Ayexor/SoundLoc/README.md

# SoundLoc

Projekt SoundLoc von

Roy Seitz 			rseitz@hsr.ch
Marco Zollinger

HSR - Hochschule für Technik Rapperswil
Oberseestrasse 10
CH-8640 Rapperswil

Modul Digital Microelectronics DigME

Git-Repo created: 2016-11-14
