Ayexor/SoundLoc/Datasheet/project_datasheet/datasheet.tex

\input{header.tex}
\usepackage{subcaption}

\begin{document}
\maketitle
\setcounter{tocdepth}{2}

\begin{figure}[htbp]
	\begin{subfigure}{0.5\textwidth}
		\centering
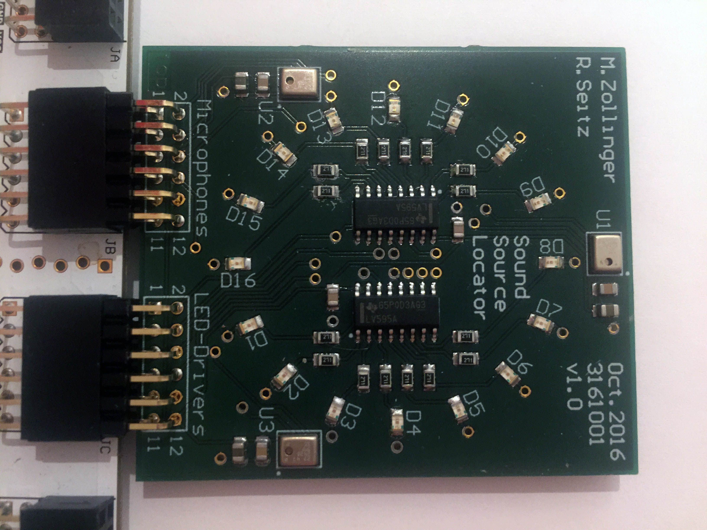
[picture p1: Datasheet/project_datasheet/block_diagram/pcb.jpg]
		
%		\captionof{figure}{SoundLoc PCB attached to FPGA board}
		\label{fig::pcb_view}
	\end{subfigure}
	\begin{subfigure}{0.5\textwidth}
		\centering
		
%		\captionof{figure}{Top Level Block Diagram}
		\label{fig::top_block}
	\end{subfigure}
	\caption{The PCB and a top level block diagram}
	\label{fig::system}
\end{figure}

\input{overview.tex}
\input{filter.tex}
\input{xcorr.tex}
\input{software.tex}
\input{display.tex}

\end{document}
