Ayexor/SoundLoc/Datasheet/project_datasheet/display.tex

\section{LED Display}
\label{sec::display}

The 16 LEDs are controlled by two 8-bit shift registers.
The LED nearest to the calculated direction is switched on every cycle.
Due to remaining noise and fast processing speed, interpolation seemingly happens by illuminating neighboring LEDs alternatively.
