Ayexor/SoundLoc/Datasheet/XCorr/block_diagram/xcorr_diag.tex

\input{picture_header}

%coordinates
\newcommand{\xt}	{0}
\newcommand{\xtc}	{0.75}
\newcommand{\xfa}	{1.5}
\newcommand{\xfac}	{2.25}
\newcommand{\xfb}	{3.0}
\newcommand{\xsat}	{4.5}
\newcommand{\xsa}	{6.0}

\newcommand{\yt}{3.0}
\newcommand{\ym}{1.5}
\newcommand{\yb}{0.0}

\begin{document}

	\tikzstyle{block} = [draw, fill=\blueFill, rectangle, minimum height=1cm, minimum width=1cm]
%	\tikzstyle{sum} = [draw, fill=\blueFill, circle, node distance=1cm]
%	\tikzstyle{input} = [coordinate]
%	\tikzstyle{output} = [coordinate]
%	\tikzstyle{pinstyle} = [pin edge={to-,thin,black}]

	\begin{tikzpicture}
%	\draw[style=my help lines] (0,0) grid (2,2);

	%top
	\draw (\xt, \yt) node[block](tau){Tau};
	\draw (\xfa, \yt) node[block](fat){$z^{-1}$};
	\draw (\xfb, \yt) node[block](fbt){$z^{-1}$};
	\draw (\xsat, \yt) node[block](sat){$z^{-1}$};
	%mid
	\draw (\xfa, \ym) node[block](FA){FA};
	\draw (\xfb, \ym) node[block](FB){FB};
	\draw (\xsa, \ym) node[block](SA){SA};
	%bottom
	\draw (\xfb, \yb) node[block](DSPA){DSP};
	\draw (\xsat, \yb) node[block](DSPB){DSP};
	
	%arrows
	\draw[->] (tau) -- (\xtc, \yt) |- (FA);
	\draw[->] (FA) |- (DSPA);
	\draw[->] (DSPA) -- (DSPB);
	\draw[->] (DSPB) -| (SA);
	
	\draw[->] (tau) -- (fat);
	\draw[->] (fat) -- (fbt);
	\draw[->] (fbt) -- (sat);
	\draw[->] (sat) -| (SA);
	
	\draw[->] (fat) -- (\xfac, \yt) |- (FB);
	\draw[->] (FB) -| (DSPB);
	
	\end{tikzpicture}
	
\end{document}
