Ayexor/SoundLoc/Datasheet/project_datasheet/software.tex

\section{Software}
\label{sec::software}

One ARM Cortex-A9 core is used in this project.
At first it configures the filter and cross-correlation blocks by setting order, decimation, IIR pole location and post division factor.
The filter delivers its values directly to the cross-correlation block, which again informs the Cortex-A9 each time recalculation is finished.
The Cortex-A9 then reads the result and searches for the maximum in the correlation which corresponds to the delay Tau of the microphone signal to the reference microphone. Tau is proportional to the signal delay caused by finite speed of sound.

If the distance between the microphones and the sound source is large compared to the distance between the microphones, the sound wave can be modeled as a plane wave.
The delays are then proportional to the inner product between the wave vector and the  distance between the correlated microphone, as expressed in (\ref{eq::inner_product}).

Since the microphones are arranged in a equilateral triangle, the two Taus are not orthogonal.
The vector $x$ directing to the source location in cartesian coordinates can be expressed as per the left side of (\ref{eq::base_transform}).
To calculate the signal delay in cartesian coordinates, $Bx$ needs to be left multiplied with $B^{-1}$, resulting in the right side of  (\ref{eq::base_transform}).

\begin{align}
	{Tau}_{0n} \propto \overrightarrow{k} \cdot &\overrightarrow{M_nM_0} \quad n\in\{1,2\}\label{eq::inner_product} \\
	\tau = Bx \quad &\Rightarrow \quad x = B^{-1}\tau \label{eq::base_transform}\\
	\begin{pmatrix} {Tau}_{01} \\ {Tau}_{02}\end{pmatrix}
		=  \begin{pmatrix} \cos(\frac{\pi}{3}) & \sin(\frac{\pi}{3}) \\ 1 & 0 \end{pmatrix} \begin{pmatrix} x \\ y\end{pmatrix}
	\quad &\Rightarrow \quad \begin{pmatrix} x \\ y \end{pmatrix}	
	= \begin{pmatrix} 0 & 1 \\ \frac{2}{\sqrt{3}} & -\frac{1}{\sqrt{3}}\end{pmatrix}
	\begin{pmatrix} {Tau}_{01} \\ {Tau}_{02}\end{pmatrix}
\end{align}

From the cartesian coordinates $x,y$, the four quadrant arctangent can easily be calculated using the C-function \emph{atan2(y,x)}.
The resulting angle is finally mapped to the corresponding LED and displayed.
