Ayexor/SoundLoc/Datasheet/project_datasheet/header.tex

\documentclass[a4papper, 11pt]{article}

\title{-- Digital Microelectronics --- SoundLoc -- \\ Localization of sound sources by cross-correlating \\ three $\Sigma\Delta$-microphone signals}
\author{Stefan Kull, Roy Seitz, Marco Zollinger}

\usepackage[T1]{fontenc}			%umlaute als eigene Zeichen
\usepackage[latin1]{inputenc}	%umlaute erkennen
\usepackage{lmodern}
\usepackage{amsmath} 					%mathematischen Textsatz.
\usepackage{amssymb}					%	-Erweiterte math. Sonderzeichen
\usepackage{dsfont}						%	-Mengen			
\usepackage[english]{babel}
\usepackage{textgreek}
\usepackage{siunitx}
\usepackage{graphicx}
\usepackage{caption}			%für \captionof

\usepackage[
	pdftitle={SoundLoc -- Digital Microelectronics Project},						%Titel des PDF Dokuments.
	pdfauthor={Stefan Kull, Roy Seitz, Marco Zollinger},									%Autor des PDF Dokuments.
	pdfsubject={Sound localization using cross-correlation of three microphones},		%Thema des PDF Dokuments.
	pdfcreator={LaTeX with hyperref and KOMA-Script},		%Erzeuger des PDF Dokuments.
	pdfkeywords={Cross-correlating, CIC, IP, AXI4\_Lite interface},						%auch für PDF Dokumente indexiert
	%	pdfpagemode=UseOutlines,								%Inhaltsverzeichnis anzeigen beim ffnen
	pdfdisplaydoctitle=true,								%Dokumenttitel statt Dateiname anzeigen.
	pdflang=en,												%Sprache des Dokuments.
	plainpages=false,
	hidelinks,												%keine Box um Links
	%	bookmarksopen.											%toc beim Öffnen expandiert
	pdfpagelabels
]{hyperref}

\usepackage[
%includeheadfoot,		%Kopf- und Fusszeilen verwenden
%headheight=15pt,		%Höhe der Kopfzeile
left=30mm,				%abstand von Seitenraendern
right=30mm,				%
top=20mm,
bottom=20mm,
%			twoside
]{geometry}
