Ayexor/SoundLoc/Hardware/layout.pdf

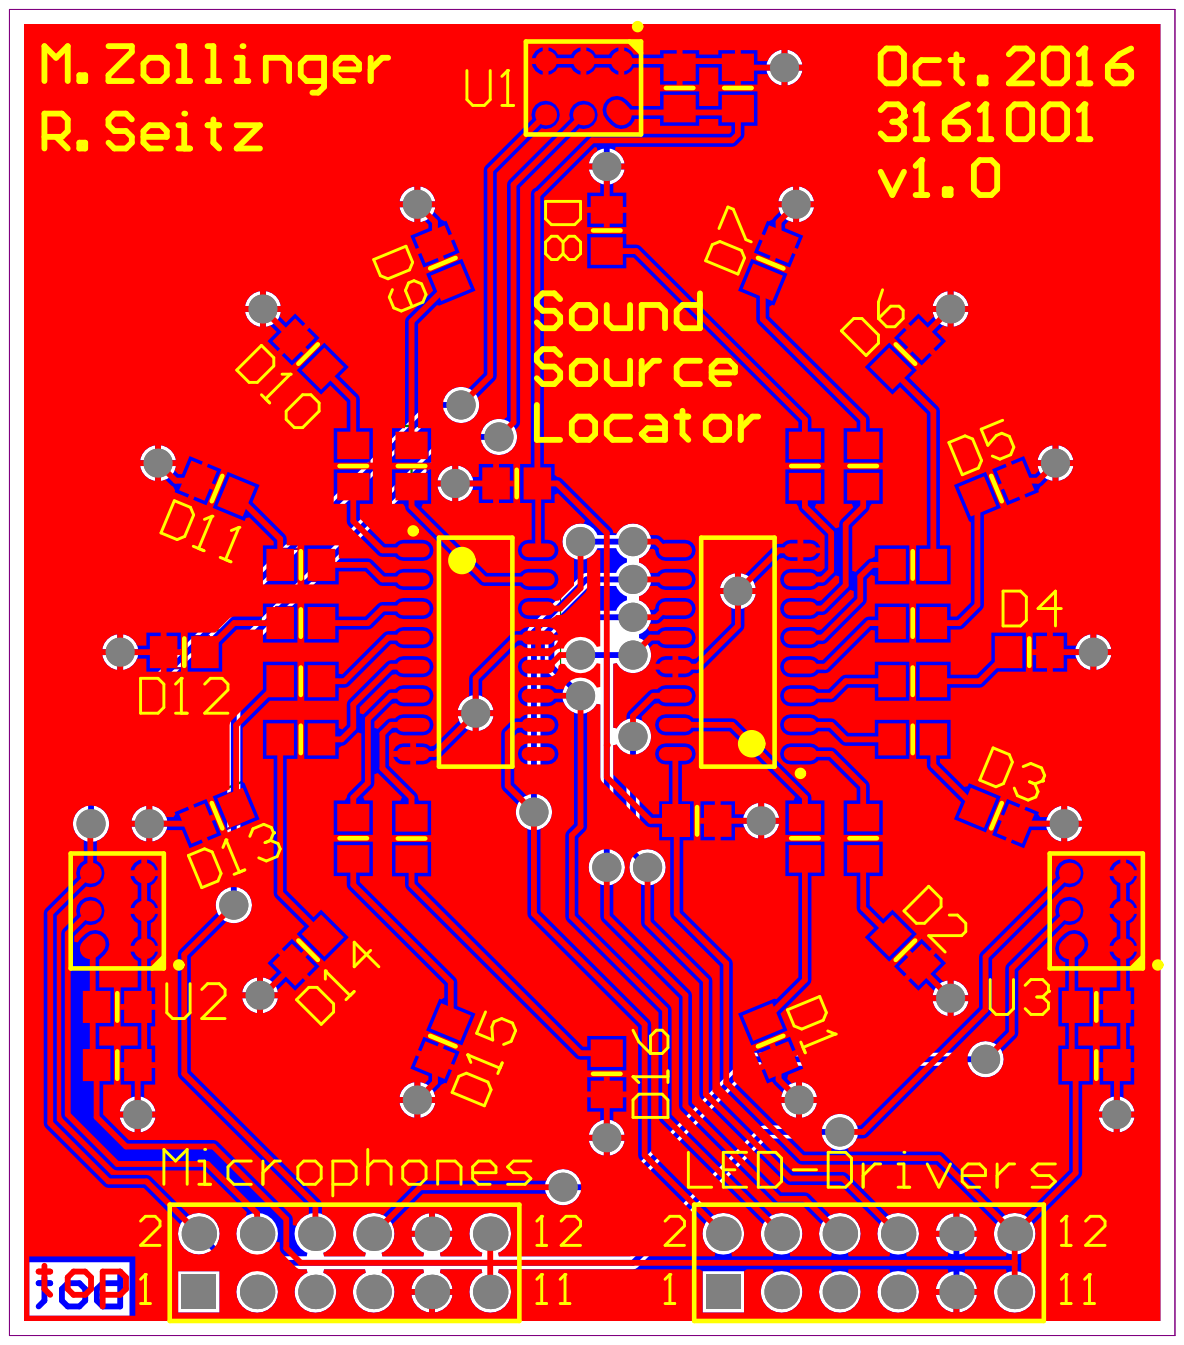
[picture p2: page 1]
