Ayexor/SoundLoc/Hardware/schematic.pdf

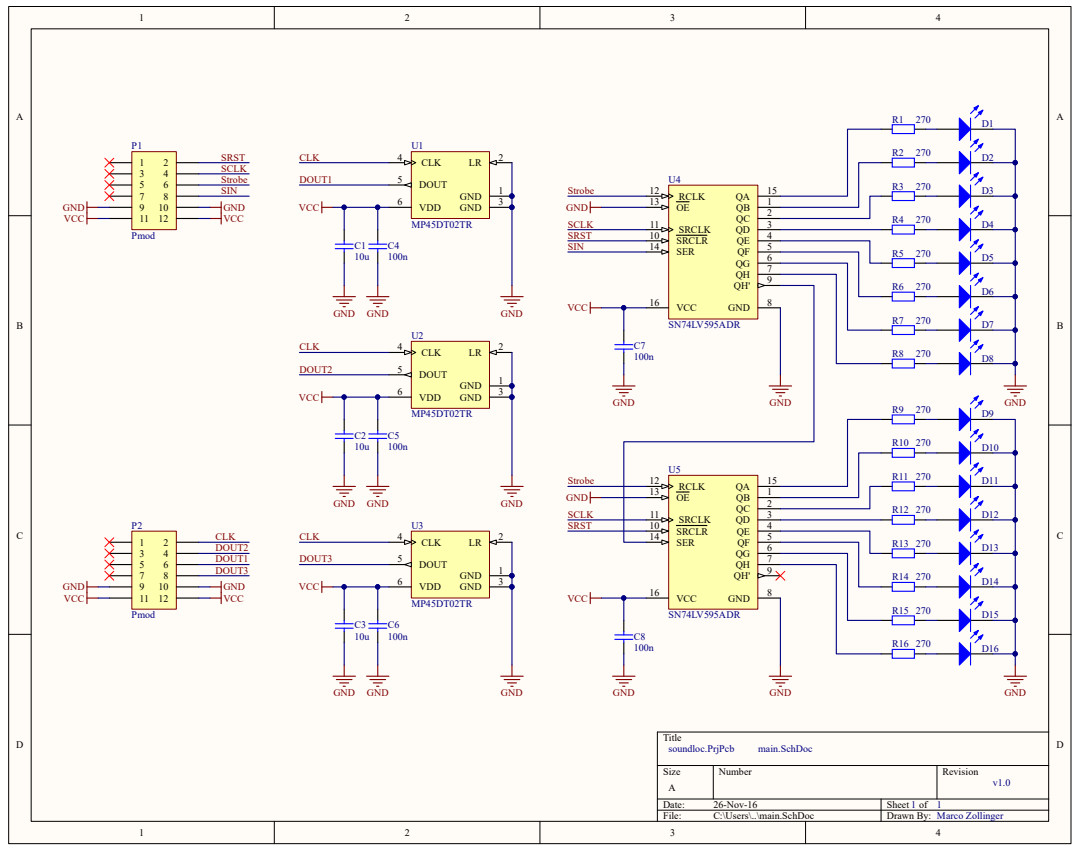
[picture p3: page 1]
