Ayexor/SoundLoc/(commit log)

2016-11-26 Offloading LED-Display control to separate library
2016-11-27 IP and IF added XCorr not working, CIC fine...
    [AXI_SH_595_v1_0.vhd, AXI_SH_595_v1_0_S_AXI.vhd, CIC.vhd, SDM_Decimator.c, SDM_Decimator.h, SDM_Decimator_v1_0.vhd, SDM_Decimator_v1_0_S_AXI.vhd, XCorr_pkg.vhd]
2016-11-27 Documentation of CIC corrected
    [SDM_Decimator.c, SDM_Decimator.h]
2016-11-27 reduced samples from 19k to 1kSample, in HW wont be much more available
2016-11-27 LED-Display: added Angle and Coordinate functions
2016-11-27 Driver corrected
2016-11-30 IIR filter now configurable by software post divider now configurable by software
    Driver updated
2016-12-02 added gerber files for pcb manufacturing
2016-12-02 added pcb-image
2016-12-02 New PCB picture Scaleing adapded
2016-12-02 Adapted so that LED display (5 rows) down't need an additional page
2016-12-31 XCorr überarbeitet Nun möglich, die Taus (max corr value) direkt auszulesen, dafür sind die einzelnen Werte der Korrelation nicht mehr verfügbar (Zu kompliziert momentan... später...) Software Suport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
2017-01-31 New XCorr IP for Soundloc, including driver
2017-01-31 C-Code for Soundloc added (Arty / MicroBlaze) new XCorr working very well - should be easily adaptable to zynq connect as follows: ap_start => new_val (SDM_Decimator) ap_done => interrupt mic val => 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
    In C-Code: use the folowing:
    XXcorr xcorr; // handle to the device
    XXcorr_Initialize(&xcorr, XPAR_XCORR_DEVICE_ID); // initialize handle
    XXcorr_Set_treshold(&xcorr, 20000) //; // set treshold
    use XXcorr_Get_tau_0(&xcorr) and XXcorr_Get_tau_1(&xcorr) to query taus
    if treshold was not reached, [0,0] is returned to signal invalid taus
